joehil/3D-printable-sound-absorbers/(list of files, cad)

Other CAD files:
cone backing with walls module 25x25.scad
