joehil/3D-printable-sound-absorbers/(commit log)

2017-01-30 Openscad file
    [absorber1.scad]
2017-02-01 Openscad files added
    [cone backing with tubes module 25x25.scad, cone backing with walls module 25x25.scad]
2017-02-01 Author of module polyhole mentioned
    [cone backing with tubes module 25x25.scad, cone backing with walls module 25x25.scad]
2017-02-02 Dimensions changed according to supplied formulas
    [cone backing with tubes module 25x25.scad, cone backing with walls module 25x25.scad]
2017-02-07 Openscad files of 2 different coil absorbers
    [coil_spiral.scad, coil_square.scad]
2017-02-07 Now two different kinds of coils
    [coil_spiral.scad]
